haikevins/Multimeter_Project/Application/app_controller.h

#ifndef APP_CONTROLLER_H
#define APP_CONTROLLER_H

#ifdef __cplusplus
extern "C" {
#endif

void AppController_Init(void);
void AppController_RunOnce(void);

#ifdef __cplusplus
}
#endif

#endif /* APP_CONTROLLER_H */
