haikevins/Multimeter_Project/Platform/platform_init.h

/**
  ******************************************************************************
  * @file    platform_init.h
  * @brief   MCU platform bootstrap boundary.
  ******************************************************************************
  */
#ifndef PLATFORM_INIT_H
#define PLATFORM_INIT_H

#ifdef __cplusplus
extern "C" {
#endif

void Platform_InitSystem(void);

#ifdef __cplusplus
}
#endif

#endif /* PLATFORM_INIT_H */
